jakabfarkas/Sebessegmero/Beadott/KiCad/step files/Female2.54MM1x15.step

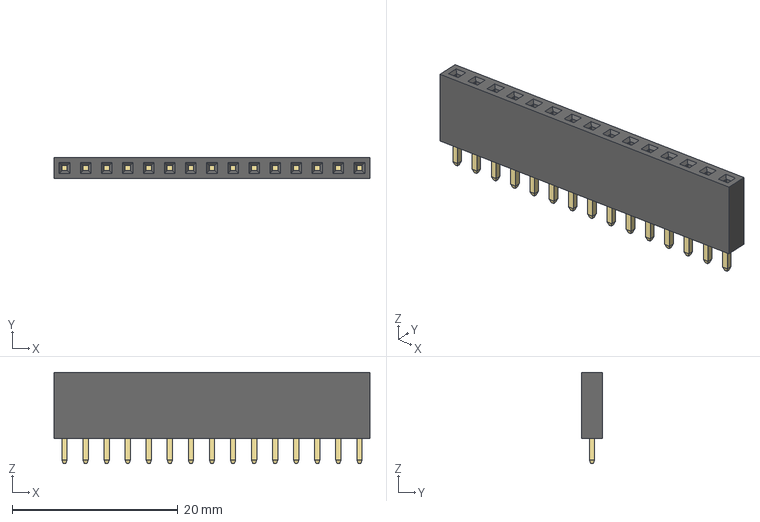
[picture p29: CAD file, 2020-12-12]
Beadott/KiCad/step files/Female2.54MM1x15.step
38.1 x 2.54 x 11.0 mm
