jakabfarkas/Sebessegmero/Beadott/KiCad/Sebessegmero.kicad_pcb

## KiCad design Beadott/KiCad/Sebessegmero.kicad_pcb (2020-12-12)

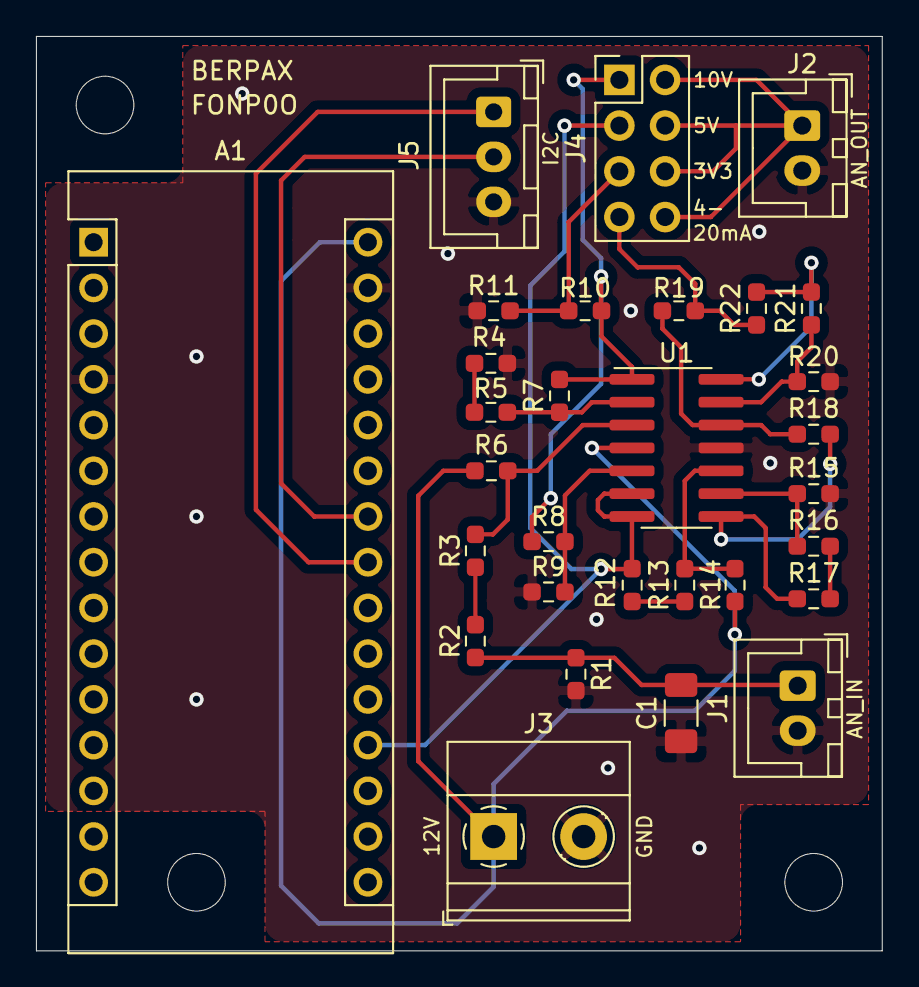
[picture p30: board Sebessegmero.kicad_pcb from above]

Board: 2 copper layers, 47.0 x 50.8 mm, 33 parts (0 on the bottom side), 23 nets.

Parts:
A1: Arduino_Nano_Every; Arduino_Nano
C1: C; C_1206_3216Metric_Pad1.33x1.80mm_HandSolder
J1, J2: Conn_01x02_Female; JST_XH_B2B-XH-A_1x02_P2.50mm_Vertical
J3: Screw_Terminal_01x02; TerminalBlock_Phoenix_MKDS-1,5-2_1x02_P5.00mm_Horizontal
J4: Conn_02x04_Odd_Even; PinHeader_2x04_P2.54mm_Vertical
J5: Conn_01x03_Female; JST_XH_B3B-XH-A_1x03_P2.50mm_Vertical
M3, M3#2, M3#3: MountingHole_3.2mm_M3
R1, R7, R8, R9, R20: 10k; R_0603_1608Metric_Pad0.98x0.95mm_HandSolder
R2, R3: 3k; R_0603_1608Metric_Pad0.98x0.95mm_HandSolder
R4: 9,1k; R_0603_1608Metric_Pad0.98x0.95mm_HandSolder
R5: 130; R_0603_1608Metric_Pad0.98x0.95mm_HandSolder
R6, R14, R15: 24k; R_0603_1608Metric_Pad0.98x0.95mm_HandSolder
R10: 2k; R_0603_1608Metric_Pad0.98x0.95mm_HandSolder
R11: 1k; R_0603_1608Metric_Pad0.98x0.95mm_HandSolder
R12, R16: 2,4k; R_0603_1608Metric_Pad0.98x0.95mm_HandSolder
R13, R17: 100; R_0603_1608Metric_Pad0.98x0.95mm_HandSolder
R18: 100k; R_0603_1608Metric_Pad0.98x0.95mm_HandSolder
R19, R21: 15k; R_0603_1608Metric_Pad0.98x0.95mm_HandSolder
R22: 47; R_0603_1608Metric_Pad0.98x0.95mm_HandSolder
U1: Opamp_Quad_Generic; SOIC-14_3.9x8.7mm_P1.27mm

Connections:
0-3V3: J4.5, R10.2, R11.1
0-5V: A1.19, J4.3, R12.1, U1.6, U1.7
0-10V: J4.1, R7.2, R8.1, R10.1, U1.1
4-20mA: J4.7, R19.1, R22.1
+12V: A1.30, J3.1, R6.1, R14.2, U1.4
GND: A1.4, A1.29, C1.2, J1.2, J2.2, J3.2, J5.3, R1.2, R4.1, R9.2, R11.2, R15.2, R20.1, U1.11
unnamed: A1.23, J5.1
unnamed: A1.24, J5.2
unnamed: C1.1, J1.1, R1.1, R2.2
unnamed: J2.1, J4.2, J4.4, J4.6, J4.8
unnamed: R2.1, R3.2
unnamed: R3.1, R6.2, U1.3
unnamed: R4.2, R5.1
unnamed: R5.2, R7.1, U1.2
unnamed: R8.2, R9.1, U1.5
unnamed: R12.2, R13.1
unnamed: R13.2, R14.1, U1.10
unnamed: R15.1, R16.1, U1.9
unnamed: R16.2, R17.2
unnamed: R17.1, R18.2, U1.8
unnamed: R18.1, R19.2, U1.12
unnamed: R20.2, R21.1, U1.13
unnamed: R21.2, R22.2, U1.14
