jakabfarkas/Sebessegmero/(commit log)

2020-11-27 ellenallas linkek
    [Sebessegmero.kicad_pcb, Sebessegmero.sch]
2020-11-27 csatlakozo linkek
    [Sebessegmero.sch]
2020-11-28 extra step fajlok
    [282837-2--3DModel-STEP-1.STEP, 87758-0816.stp]
2020-12-02 Footprint by Zsombi
    [Sebessegmero.kicad_pcb, Sebessegmero.sch]
2020-12-02 farkas layoutja
    [Sebessegmero.kicad_pcb, Sebessegmero.sch]
2020-12-02 farkas layout
    [Sebessegmero.kicad_pcb, Sebessegmero.sch]
2020-12-12 kesz aramkor
    [BOM.csv, Female2.54MM1x15.step, Sebessegmero.kicad_pcb, Sebessegmero.sch]
2020-12-12 doksi 3.0
    [Sebessegmero.kicad_pcb]
